trevinlake/WildcatRacing/README.md

# WildcatRacing
This repository has documentation on readthedocs. It can be accessed via the following link:
<a href="https://wildcatracing.rtfd.io" target="_blank">WildcatRacing</a>
