trevinlake/WildcatRacing/docs/index.rst

.. WildcatRacing documentation master file, created by
   sphinx-quickstart on Wed Nov 30 09:05:10 2022.
   You can adapt this file completely to your liking, but it should at least
   contain the root `toctree` directive.
   
Wildcat Racing
=========================================

Welcome to Wildcat Racing! Here you will find documentation for Weber State University's F1Tenth 2022 Race Team.

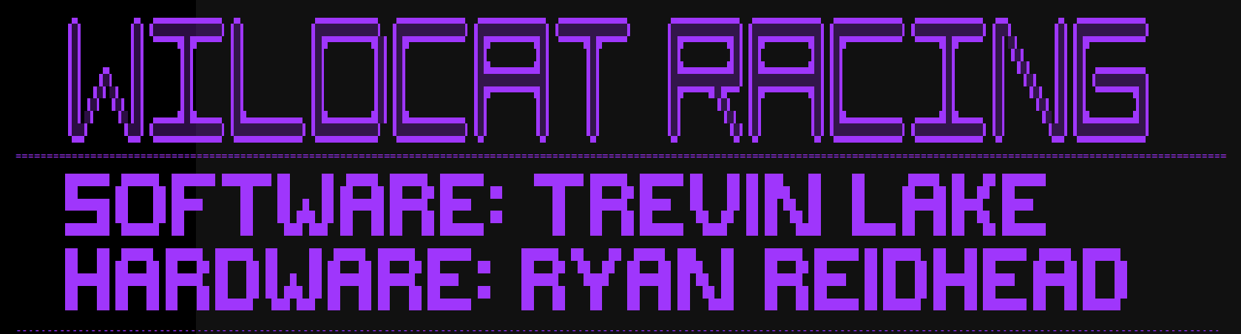
[picture p2: docs/images/wildcat_racing_retro.png]


.. toctree::
   :hidden:

    self   
   
.. toctree::
   :caption: Table of Contents

.. toctree::
   :maxdepth: 2
   :caption: Software
   
   architecture
   ros_code
   launcher_gui
   other_scripts

.. toctree::
   :maxdepth: 2
   :caption: Sensors

   lidar
   inertial_measurement_unit
   hall_effect
   
.. toctree::
   :maxdepth: 2
   :caption: Hardware
   
   bom
   schematics
   datasheets
   drawings
   
.. toctree::
    :caption: Links

    Weber State University Electrical and Computer Engineering <https://weber.edu/ece>
    F1Tenth <https://f1tenth.org>
    Code Repository <https://github.com/trevinlake/WildcatRacing>
    Discord <https://discord.gg/KXRFZF949C>
