trevinlake/WildcatRacing/docs/drawings.rst

3D Printed Parts
===============================
