trevinlake/WildcatRacing/docs/sensors.rst

Sensors
========================
..toctree::
:maxdepth: 2

lidar
imu
hall_effect
