trevinlake/WildcatRacing/Hardware Documentation/altium/Project Outputs for Wildcat Racing/Wildcat Racing.xlsx

Line # | Name | Description | Designator | Revision ID | Revision State | Revision Status | Quantity | Manufacturer 1 | Manufacturer Part Number 1 | Manufacturer Lifecycle 1 | Supplier 1 | Supplier Part Number 1 | Supplier Unit Price 1 | Supplier Subtotal 1
 | 20SVP150M | Conductive Polymer Aluminum Solid Capacitors (OS-CON) 150uF ±20% 20V RADIAL SMT 10x12.6mm | C1 | CMP-05428-000386-1 | New From Design | Up to date | 1 | Panasonic | 20SVP150M | Volume Production | Arrow Electronics | 20SVP150M | 2.28 | 2.28
 | CL10F474ZA8NNNC | Cap Ceramic 470nF 25V Y5V -20/+80% Pad SMD 0603 +85°C T/R | C2 | CMP-13271-004088-1 | New From Design | Up to date | 1 | Samsung | CL10F474ZA8NNNC | Volume Production | Digi-Key | 1276-2376-1-ND | 0.12 | 0.12
 | TPCL105M010R5000 |  | C3 | CMP-2006-00208-1 | Released | Up to date | 1 | Kyocera AVX | TPCL105M010R5000 | Volume Production | Digi-Key | 478-5352-1-ND | 1.14 | 1.14
 | CL03A104KP3NNNC | Cap Ceramic 100nF 10V X5R ±10% Pad SMD 0201 +85°C T/R | C4 | CMP-2010-00672-2 | New From Design | Up to date | 1 | Samsung | CL03A104KP3NNNC | Volume Production | Newark | 82AC9158 | 0.003 | 0.003
 | GRM155R71C104KA88D | CAP CER 0.1UF 16V X7R 0402 | C5 | CMP-2100-03641-2 | New From Design | Up to date | 1 | Murata | GRM155R71C104KA88D | Unknown | Arrow Electronics | GRM155R71C104KA88D | 0.0666 | 0.0666
 | GRM31CR71H475KA12L | Chip Multilayer Ceramic Capacitors for General Purpose, 1206, 4.7uF, X7R, 15%, 10%, 50V | C6, C7 | CMP-1037-04923-3 | New From Design | Up to date | 2 | Murata | GRM31CR71H475KA12L | Volume Production | Newark | 08AC2721 | 0.099 | 0.198
 | GRM188R72A104KA35D | Chip Multilayer Ceramic Capacitors for General Purpose, 0603, 0.10uF, X7R, 15%, 10%, 100V | C8, C9 | CMP-1035-02595-8 | New From Design | Up to date | 2 | Murata | GRM188R72A104KA35D | Volume Production | Newark | 03AC2685 | 0.049 | 0.098
 | C0805C106K8PACTU | CAP CER 10UF 10V X5R 0805 | C10, C11 | CMP-2007-03243-2 | New From Design | Up to date | 2 | KEMET | C0805C106K8PACTU | Volume Production | Allied Electronics | 70095566 | 0.077 | 0.154
 | CGA3E2X7R1H104K080AA | Cap Ceramic 100nF 50V X7R 10% Pad SMD 0603 +125°C Automotive T/R | C12 | CMP-2000-07546-2 | New From Design | Up to date | 1 | TDK | CGA3E2X7R1H104K080AA | Volume Production | Newark | 25AC6861 | 0.014 | 0.014
 | GRM1555C1H1R0CA01D |  | C13 | CMP-2008-04277-1 | Released | Up to date | 1 | Murata | GRM1555C1H1R0CA01D | Unknown | Arrow Electronics | GRM1555C1H1R0CA01D | 0.064 | 0.064
 | C1608X5R1H105K080AB | Multilayer Ceramic Capacitors 1μF ±10% 50V X5R SMD 0603 | C14 | CMP-2000-06025-2 | Released | Up to date | 1 | TDK | C1608X5R1H105K080AB | Volume Production | Newark | 78Y9917 | 0.035 | 0.035
 | IPL1-104-02-L-D-K | 4 Position 2 Row .100" (2.54 mm) pitch connector | J1, J3 | CMP-02766-000804-1 | New From Design | Up to date | 2 | Samtec | IPL1-104-02-L-D-K | Volume Production | Avnet | IPL1-104-02-L-D-K | 3.63 | 7.26
 | 20020316-H021B01LF | No Description Available | J2, J4, J5 |  | Not managed |  | 3
 | 78438357018 | FIXED IND 1.8UH 5.8A 21MOHM SMD | L1 | CMP-207846-000027-1 | New From Design | Up to date | 1 | Wurth Electronics | 78438357018 | Unknown | Farnell | 3551739 | 1.6 | 1.6
 | CRCW04021M13FKED |  | R1 | CMP-1011-00854-2 | Released | Up to date | 1 | Vishay | CRCW04021M13FKED | Volume Production | Arrow Electronics | CRCW04021M13FKED | 0.0156 | 0.0156
 | CRCW0402100KFKED | RES Thick Film, 100kΩ, 1%, 0.063W, 100ppm/°C, 0402 | R2, R3, R4 | CMP-2002-08123-3 | New From Design | Up to date | 3 | Vishay Dale | CRCW0402100KFKED | Unknown
 | CRCW04029K09FKED | RES Thick Film, 9.09kΩ, 1%, 0.063W, 100ppm/°C, 0402 | R5 | CMP-2002-00285-2 | New From Design | Up to date | 1 | Vishay | CRCW04029K09FKED | Volume Production | Avnet | 52K7332 | 0.1 | 0.1
 | ADC104S021CIMMX/NOPB | 4 Channel, 50 kSPS to 200 kSPS, 10-Bit A/D Converter, 10-pin Mini SOIC, Pb-Free | U1 | CMP-0054-00490-2 | Released | Up to date | 1 | TI National Semiconductor | ADC104S021CIMMX/NOPB | Volume Production | Mouser | 926-A104S021CIMMXNPB | 3.09 | 3.09
 | LM2940CS-12/NOPB | 1A Low Dropout Regulator, 3-pin TO-263, Pb-Free | U2 | CMP-0062-00534-4 | Released | Up to date | 1 | TI National Semiconductor | LM2940CS-12/NOPB | Volume Production | Digi-Key | LM2940CS-12/NOPB-ND | 2.73 | 2.73
 | LMR33630CQRNXRQ1 | No Description Available | U3 |  | Not managed |  | 1
