trevinlake/WildcatRacing/Hardware Documentation/Lidar mount assembly.SLDASM

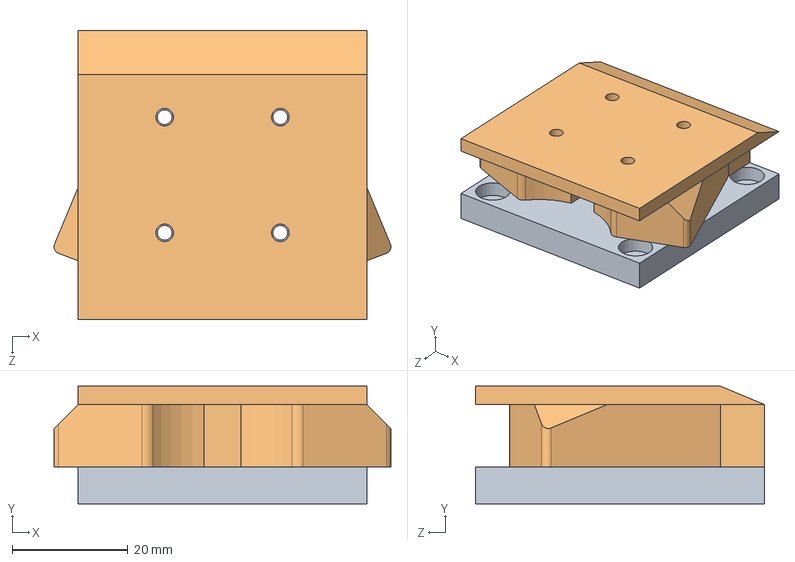
[picture p6: CAD file, 2022-12-13]
Hardware Documentation/Lidar mount assembly.SLDASM
58.3 x 20.3 x 50.0 mm
Lidar base plate
Lidar inset
