trevinlake/WildcatRacing/Hardware Documentation/altium/Project Outputs for Free Documents/ExportSTEP/12V Power.step

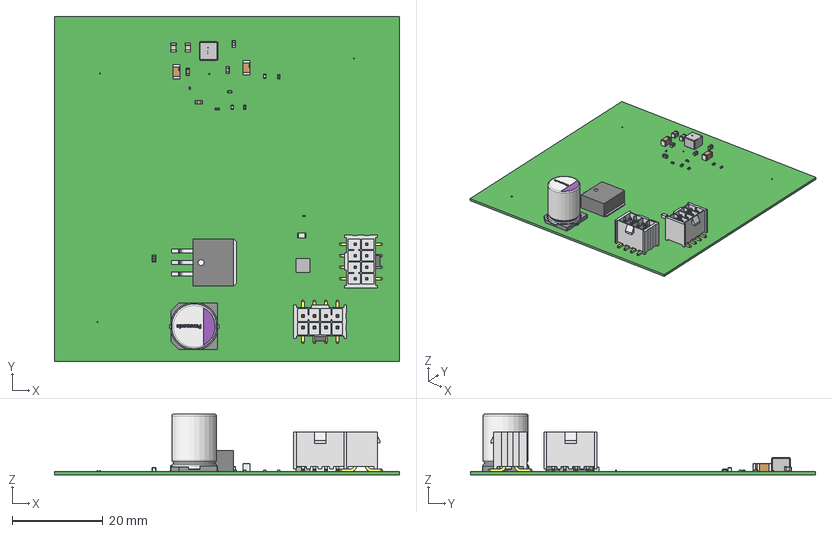
[picture p7: CAD file, 2022-12-13]
Hardware Documentation/altium/Project Outputs for Free Documents/ExportSTEP/12V Power.step
76.2 x 76.2 x 13.4 mm
Extruded x 14
top x 4
Vishay x 4
Murata Logo 3 x 2
side x 6
Murata x 2
Cap_Murata_GRM155R71C104KA88D_eec
Lead x 3
Wurth Elektonik Logo 1
Wurth Elektonik Logo
Conn_Samtec_IPL1-104-02-L-D-K_eec x 2
Pads
TDK_Logo
TDK Logo
Cap_Kemet_C0805C106K8PACTU_eec x 6
Samsung logo x 2
Cap_Panasonic_35SVPK330M_eec x 6
