trevinlake/WildcatRacing/Hardware Documentation/Big Shock Cap.SLDPRT

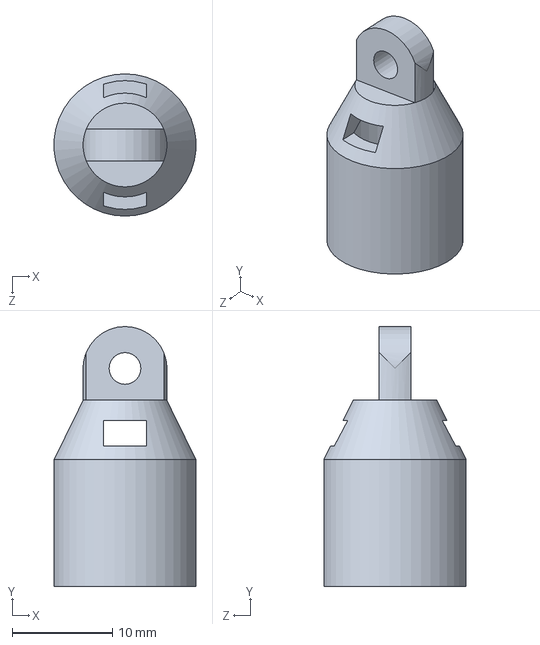
[picture p8: CAD file, 2022-12-13]
Hardware Documentation/Big Shock Cap.SLDPRT
14.2 x 26.0 x 14.2 mm
