trevinlake/WildcatRacing/Hardware Documentation/Small Shock Cap.SLDPRT

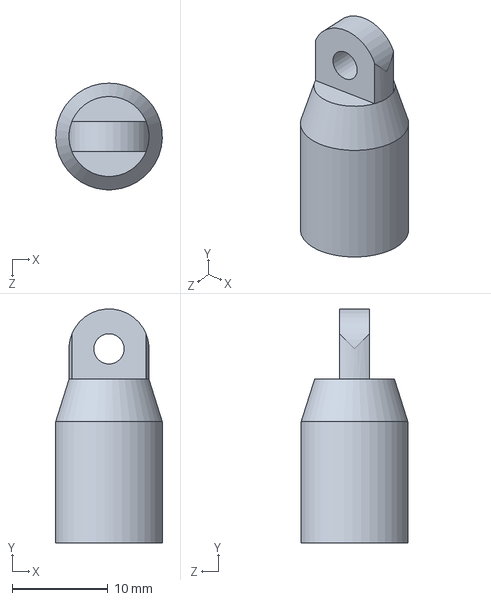
[picture p9: CAD file, 2022-12-13]
Hardware Documentation/Small Shock Cap.SLDPRT
11.2 x 24.5 x 11.2 mm
