trevinlake/WildcatRacing/Hardware Documentation/F1tenth top deck.SLDPRT

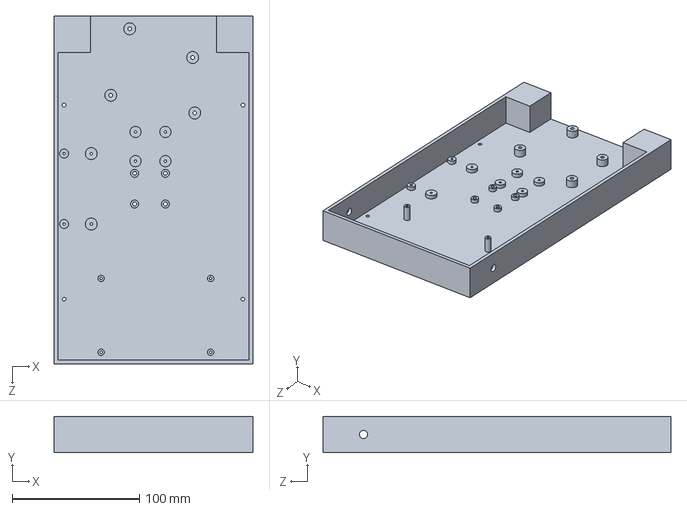
[picture p10: CAD file, 2022-12-13]
Hardware Documentation/F1tenth top deck.SLDPRT
156.2 x 28.6 x 273.0 mm
