trevinlake/WildcatRacing/Hardware Documentation/PCA9685 v18.SLDPRT

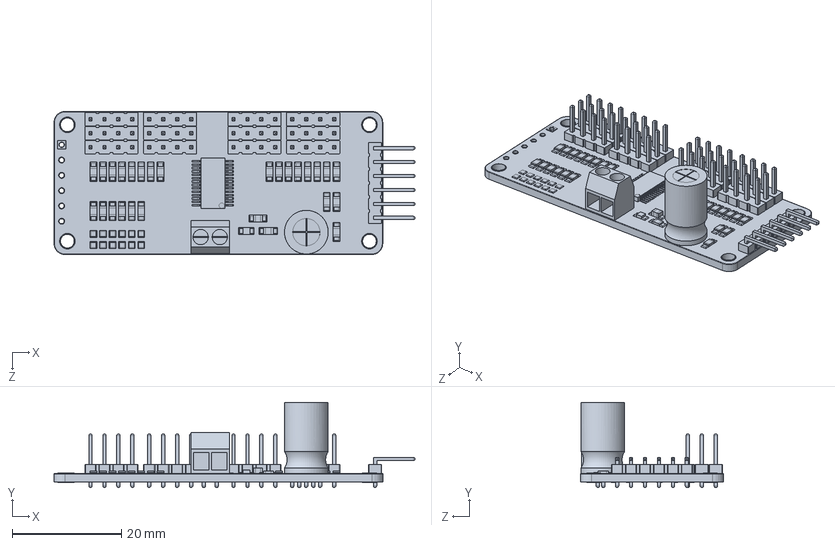
[picture p11: CAD file, 2022-12-13]
Hardware Documentation/PCA9685 v18.SLDPRT
66.1 x 15.6 x 26.2 mm
