trevinlake/WildcatRacing/Hardware Documentation/Lidar base plate.SLDPRT

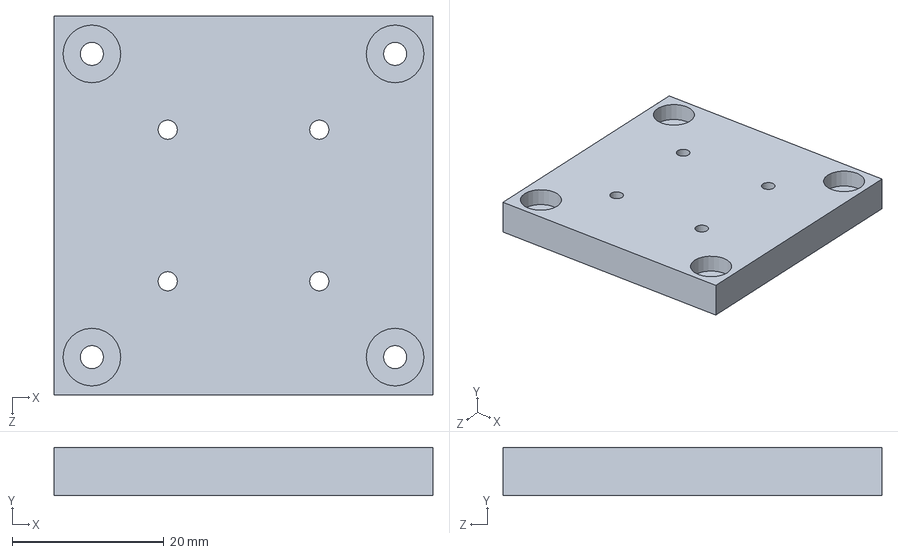
[picture p12: CAD file, 2022-12-13]
Hardware Documentation/Lidar base plate.SLDPRT
50.0 x 6.35 x 50.0 mm
