trevinlake/WildcatRacing/Hardware Documentation/adis.SLDPRT

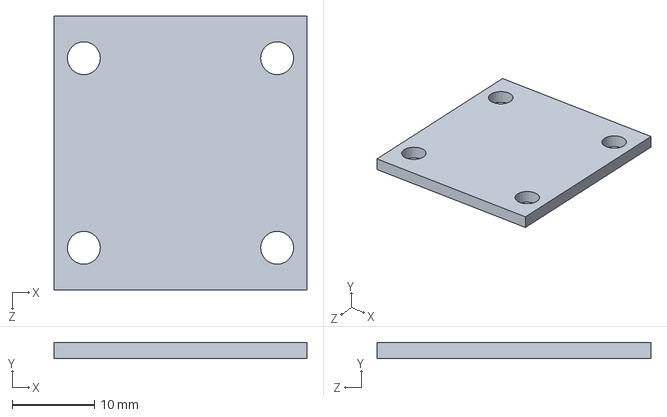
[picture p13: CAD file, 2022-12-13]
Hardware Documentation/adis.SLDPRT
30.7 x 2.00 x 33.2 mm
