trevinlake/WildcatRacing/Hardware Documentation/Lidar inset.SLDPRT

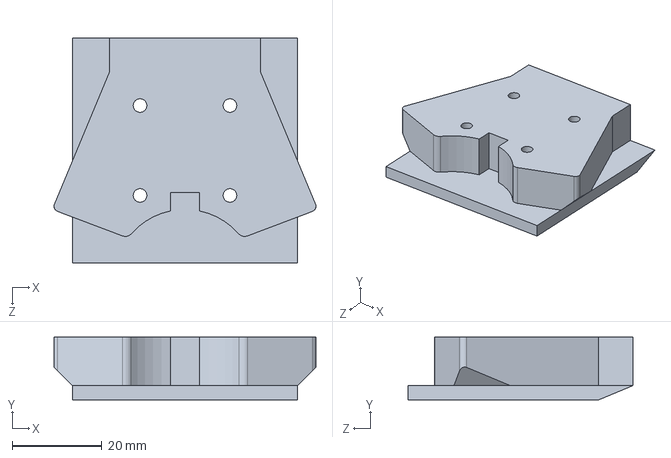
[picture p14: CAD file, 2022-12-13]
Hardware Documentation/Lidar inset.SLDPRT
58.3 x 14.0 x 50.0 mm
