trevinlake/WildcatRacing/(list of files, cad)

Other CAD files:
Hardware Documentation/Big Shock Cap.STL
Hardware Documentation/F1tenth top deck.STL
Hardware Documentation/Lidar base plate.STL
Hardware Documentation/Lidar inset.STL
Hardware Documentation/Small Shock Cap.STL
