trevinlake/WildcatRacing/Hardware Documentation/F1TENTH ORDER LIST - Sheet1.pdf

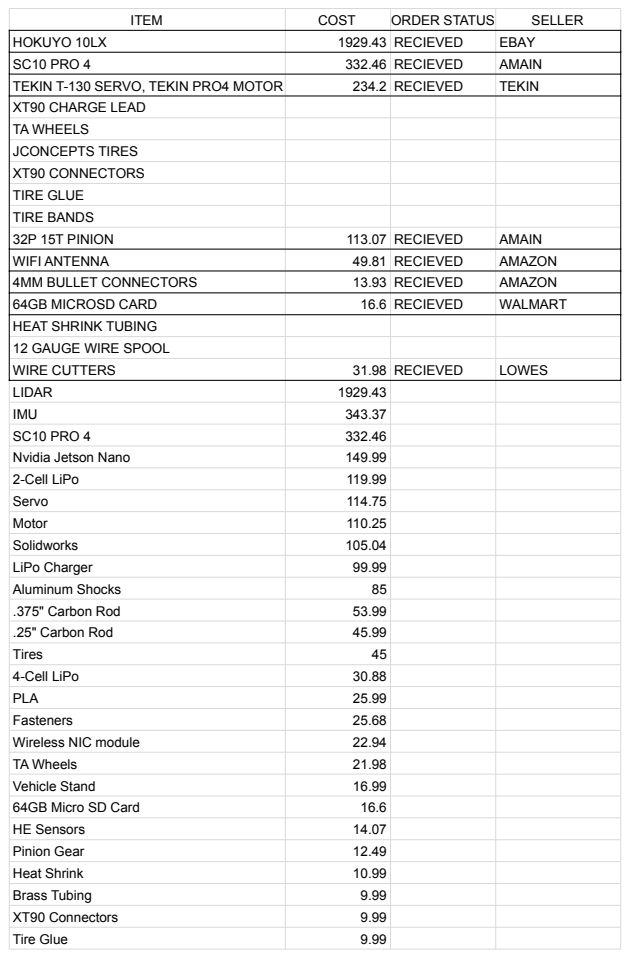
[picture p15: page 1]
ITEM; COST; ORDER STATUS; SELLER; HOKUYO 10LX; 1929.43 RECIEVED; EBAY; SC10 PRO 4; 332.46 RECIEVED; AMAIN; TEKIN T-130 SERVO, TEKIN PRO4 MOTOR; 234.2 RECIEVED; TEKIN; 32P 15T PINION; 113.07 RECIEVED; WIFI ANTENNA; 49.81 RECIEVED; AMAZON; 4MM BULLET CONNECTORS; 13.93 RECIEVED; 64GB MICROSD CARD; 16.6 RECIEVED; WALMART; WIRE CUTTERS; 31.98 RECIEVED; LOWES; LIDAR; IMU; Nvidia Jetson Nano; 2-Cell LiPo; Servo; Motor; Solidworks; LiPo Charger; Aluminum Shocks; .375" Carbon Rod; .25" Carbon Rod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

XT90 CHARGE LEAD
TA WHEELS
JCONCEPTS TIRES
XT90 CONNECTORS
TIRE GLUE
TIRE BANDS
HEAT SHRINK TUBING
12 GAUGE WIRE SPOOL

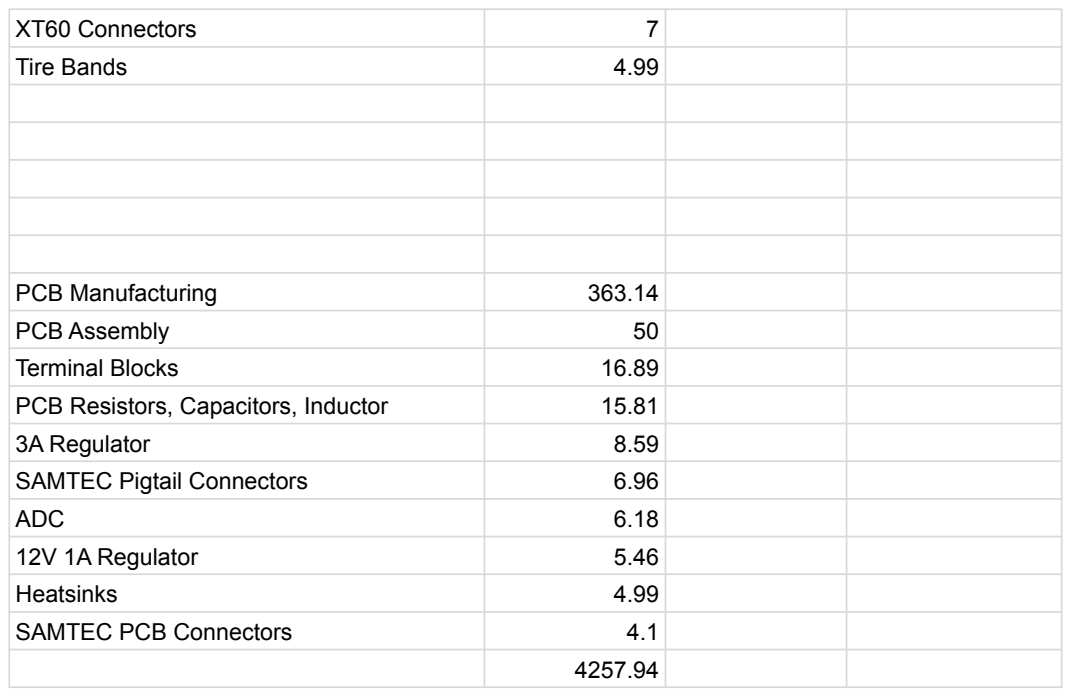
[picture p16: page 2]
XT60 Connectors; Tire Bands; PCB Manufacturing; PCB Assembly; Terminal Blocks; PCB Resistors, Capacitors, Inductor; 3A Regulator; SAMTEC Pigtail Connectors; ADC; 12V 1A Regulator; Heatsinks; SAMTEC PCB Connectors
