trevinlake/WildcatRacing/Wildcat Racing Node Diagram.pdf

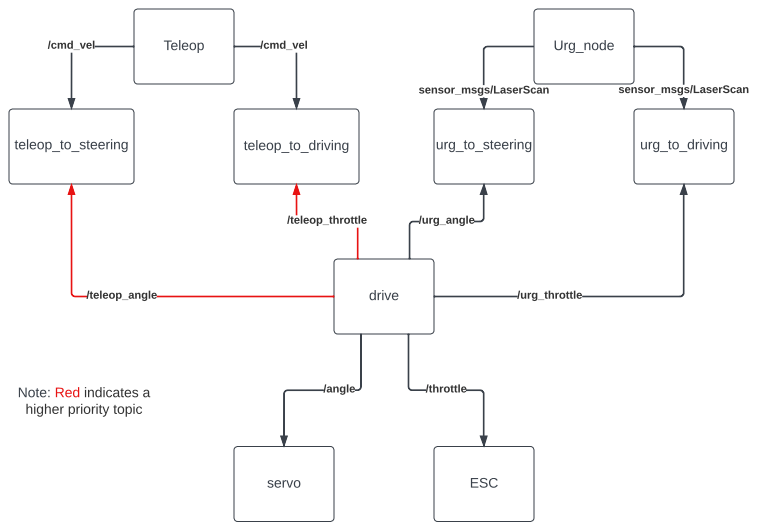
[picture p17: page 1]
Teleop; Urg_node; urg_to_steering; urg_to_driving; servo; ESC; teleop_to_steering; teleop_to_driving; /cmd_vel; sensor_msgs/LaserScan; /teleop_angle; drive; /teleop_throttle; /urg_angle; /urg_throttle; /angle; /throttle

Note: Red indicates a
higher priority topic
