trevinlake/WildcatRacing/(list of files, drawings)

Other design files:
Hardware Documentation/altium/12V Power lib.PcbLib
Hardware Documentation/altium/12V Power lib.SchLib
Hardware Documentation/altium/12V Power.PcbDoc
Hardware Documentation/altium/12V Power.SchDoc
Hardware Documentation/altium/Wildcat Racing.PrjPcb
