trevinlake/WildcatRacing/catkin_ws/src/wildcat_racing/scripts/drive.py

#! /usr/bin/env python3.7
# -*- coding: utf-8 -*-
import rospy
from adafruit_servokit import ServoKit
from std_msgs.msg import Float64
from std_msgs.msg import Float32
import numpy as np

kit = ServoKit(channels=16)

class Drive:

    # Drive Servo info:
    # The drive servo as configured above will take range 0.00 to 1.00
    # where 0 is complete stop and 1 is full throttle.

    def __init__(self):
        self.speed = 0
        self.teleop_speed_subscriber = rospy.Subscriber('/teleop_speed', Float64, self.teleop_callback)
        self.lidar_speed_subscriber = rospy.Subscriber('/lidar_speed', Float32, self.lidar_callback)

    def teleop_callback(self, msg):
        rospy.loginfo(rospy.get_caller_id() + "Latest teleop_speed was: %s\n", msg)
        new_speed = Float64()
        if msg != 0:
            new_speed = msg.data
            self.speed = msg.data
            kit.continuous_servo[2].throttle = new_speed
        else:
            self.speed = 0

    def lidar_callback(self, msg):
        rospy.loginfo(rospy.get_caller_id() + "Latest lidar_speed was: %s\n", msg)
        new_speed = Float32()
        #Priority is given to teleop since self.angle is only updated by teleop.
        if self.speed == 0:
            new_speed = msg.data
            kit.continuous_servo[2].throttle = new_speed

if __name__ == '__main__':
    print("Running drive node.")
    rospy.init_node('drive')
    Drive()
    rospy.spin()
