trevinlake/WildcatRacing/(commit log)

2022-09-15 Steering servo and Drive Motor calibration test code.
2022-09-15 Split urg_to_directions node into 2 separate steering and driving nodes.
2022-09-15 updated drive motor to port 2
2022-09-17 Pulse widths and calibration complete
2022-10-26 updated drive servo info comment
2022-10-29 updated launch files to open servo and drive nodes
2022-11-10 swapped left and right teleop code to yield matching (not inverse) mapping
    [teleop_to_steering.py]
2022-11-10 completed steering swap
2022-11-10 fixed reference to angle_count before assignment error
    [race_lidar_to_driving.py, test_lidar_to_driving.py]
2022-11-10 corrected name of ranges_arr
    [race_lidar_to_driving.py, race_lidar_to_steering.py, test_lidar_to_driving.py, test_lidar_to_steering.py]
2022-11-10 fixed bad array call
    [race_lidar_to_driving.py, race_lidar_to_steering.py, test_lidar_to_driving.py, test_lidar_to_steering.py]
2022-11-10 Changed teleop drive to have a less aggressive throttle response.
2022-11-11 updated driving and steering code
2022-11-15 LiDAR Test modes(Teleop and LiDAR) working
2022-11-16 IMU is ready for demo day
2022-11-30 documentation framework
2022-12-06 Update and rename imu.rst to inertial_measurement_unit.rst
